tscnlab/Calibration-Adapters-HTC_Vive_Pro_Eye/images/render_radiometric_adapter_front_with_spectroradiometer.jpg

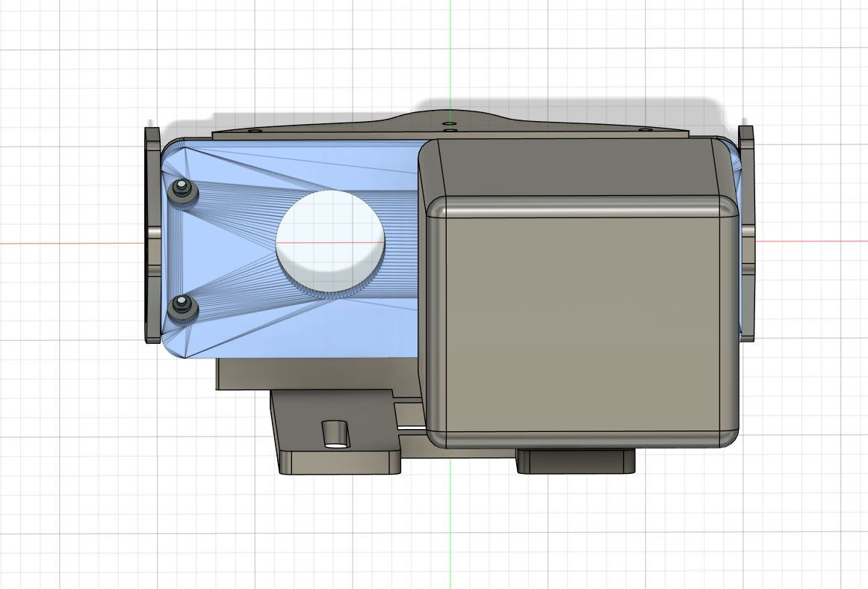
images/render_radiometric_adapter_front_with_spectroradiometer.jpg
