tscnlab/Calibration-Adapters-HTC_Vive_Pro_Eye/README.md

# 3D-printed adapters for standardized radiometric, photometric and temporal display calibration measurements of the HTC Vive Pro Eye virtual reality headset

## Technical note

**Maydel Fernandez-Alonso¹, Carolina Guidolin¹, Alexander Baum², Jannick Romanowski², Markus Scheu², Manuel Spitschan¹˒³**  

¹ Max Planck Research Group Translational Sensory and Circadian Neuroscience, Max Planck Institute for Biological Cybernetics, Tübingen, Germany  
² Fine Mechanical Workshop, Max Planck Institute for Biological Cybernetics, Tübingen, Germany  
³ Chronobiology and Health, TUM School of Medicine and Health, Technical University of Munich, Munich, Germany

### Citation

For citation, see the `CITATION.cff` file.

APA reference:

> Fernandez-Alonso, M., Guidolin, C., Baum, A., Romanowski, J., Scheu, M., & Spitschan, M. (2025). 3D-printed adapters for standardized radiometric, photometric and temporal display calibration measurements of the HTC Vive Pro Eye virtual reality headset [Technical note]. https://doi.org/10.5281/zenodo.15229214

### Included files

The following files are included with this technical note:

- `technical_note.pdf`: Technical note describing the content of this repository

- `models/`: 3D models for the adapters  
  - `radiometric_adapter.step`: 3D model for radiometric adapter  
  - `temporal_response_adapter.step`: 3D model for temporal adapter  

- `images/`: Rendered images of the adapters  
  - `render_radiometric_adapter_bottom.jpg`  
  - `render_radiometric_adapter_front_with_spectroradiometer.jpg`  
  - `render_radiometric_adapter_front.jpg`  
  - `render_radiometric_adapter_side.jpg`  
  - `render_radiometric_adapter_top.jpg`  
  - `render_temporal_adapter_bottom.jpg`  
  - `render_temporal_adapter_front_with_cover_plate.jpg`  
  - `render_temporal_adapter_front_without_cover_plate.jpg`  
  - `render_temporal_adapter_side.jpg`  
  - `render_temporal_adapter_top.jpg`  

- `LICENSE.txt`: Licensing terms

- `CITATION.cff`: Citation information
