tscnlab/Calibration-Adapters-HTC_Vive_Pro_Eye/images/render_radiometric_adapter_bottom.jpg

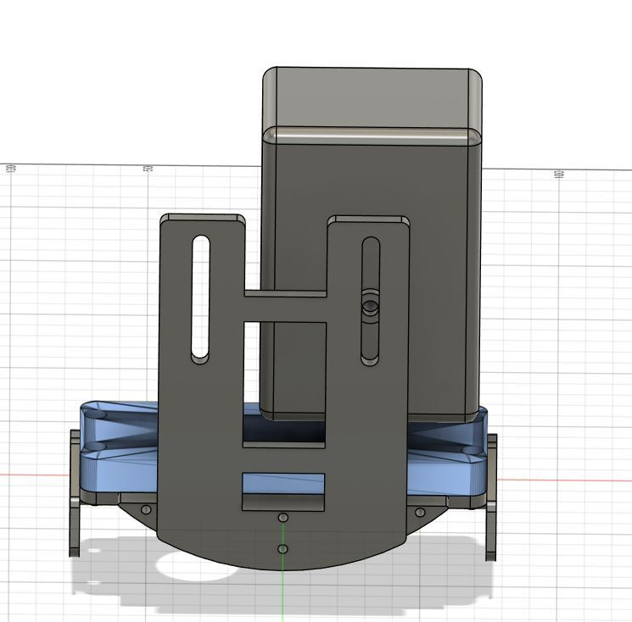
images/render_radiometric_adapter_bottom.jpg
