tscnlab/Calibration-Adapters-HTC_Vive_Pro_Eye/images/render_temporal_adapter_bottom.jpg

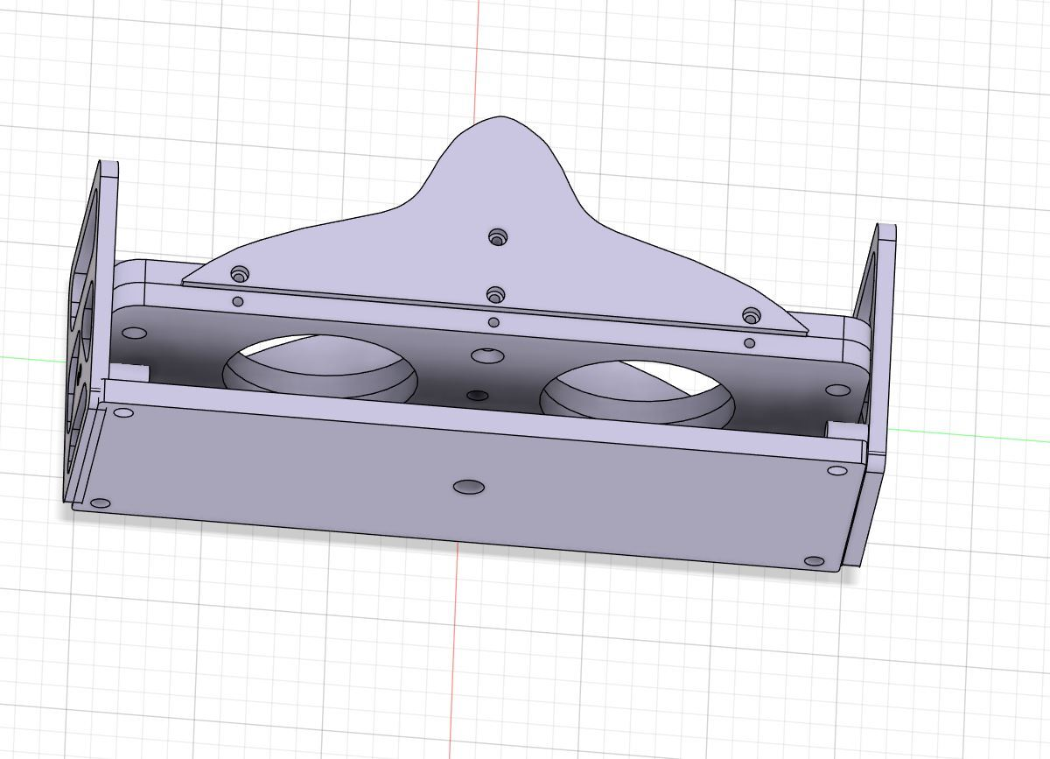
images/render_temporal_adapter_bottom.jpg
