tscnlab/Calibration-Adapters-HTC_Vive_Pro_Eye/images/render_temporal_adapter_front_without_cover_plate.jpg

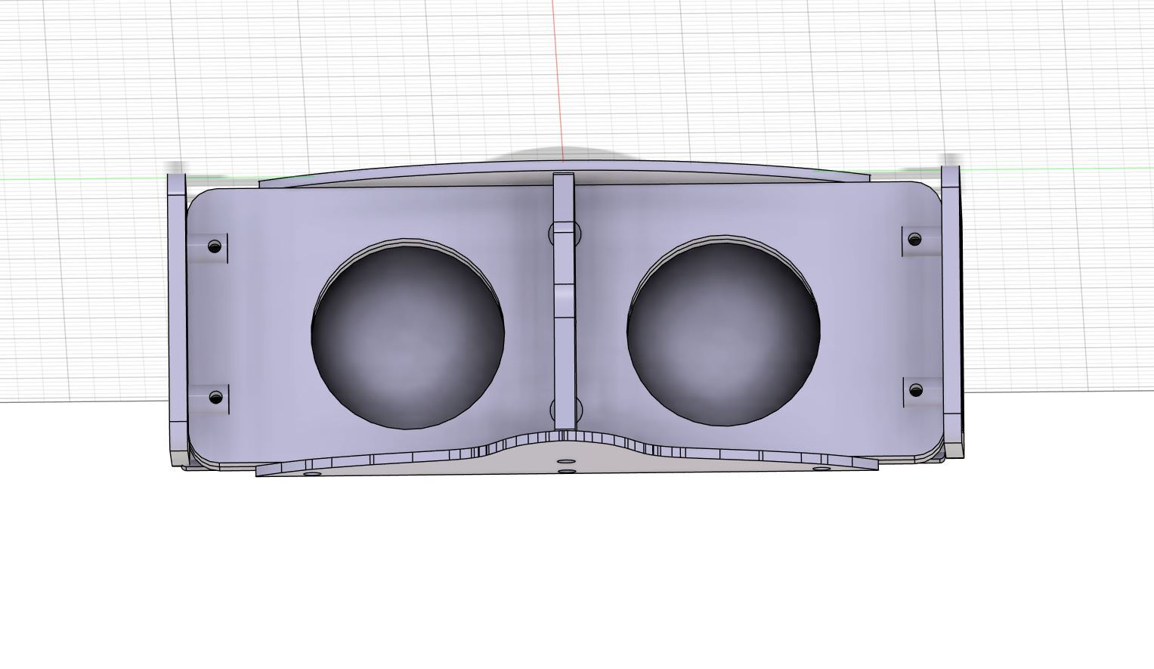
images/render_temporal_adapter_front_without_cover_plate.jpg
