tscnlab/Calibration-Adapters-HTC_Vive_Pro_Eye/images/render_temporal_adapter_side.jpg

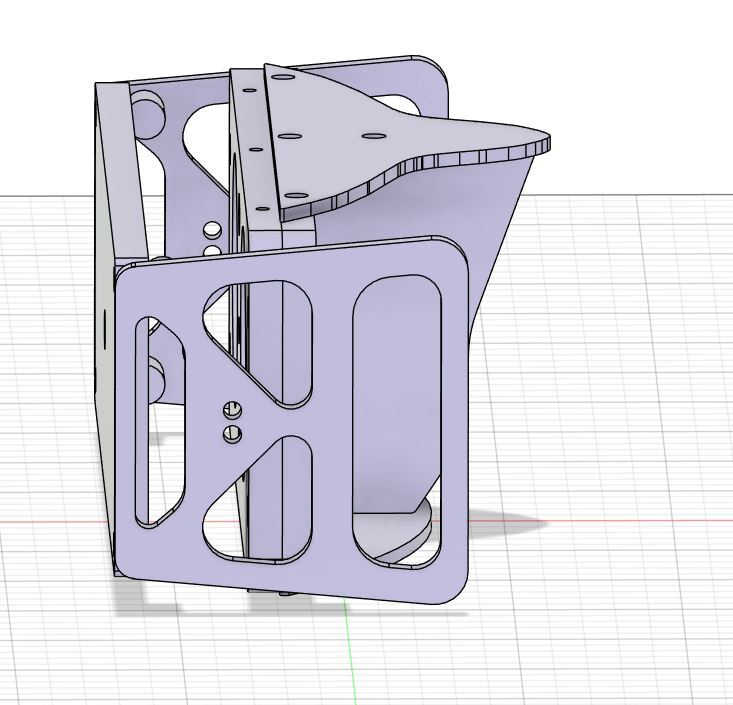
images/render_temporal_adapter_side.jpg
