tscnlab/Calibration-Adapters-HTC_Vive_Pro_Eye/images/render_temporal_adapter_top.jpg

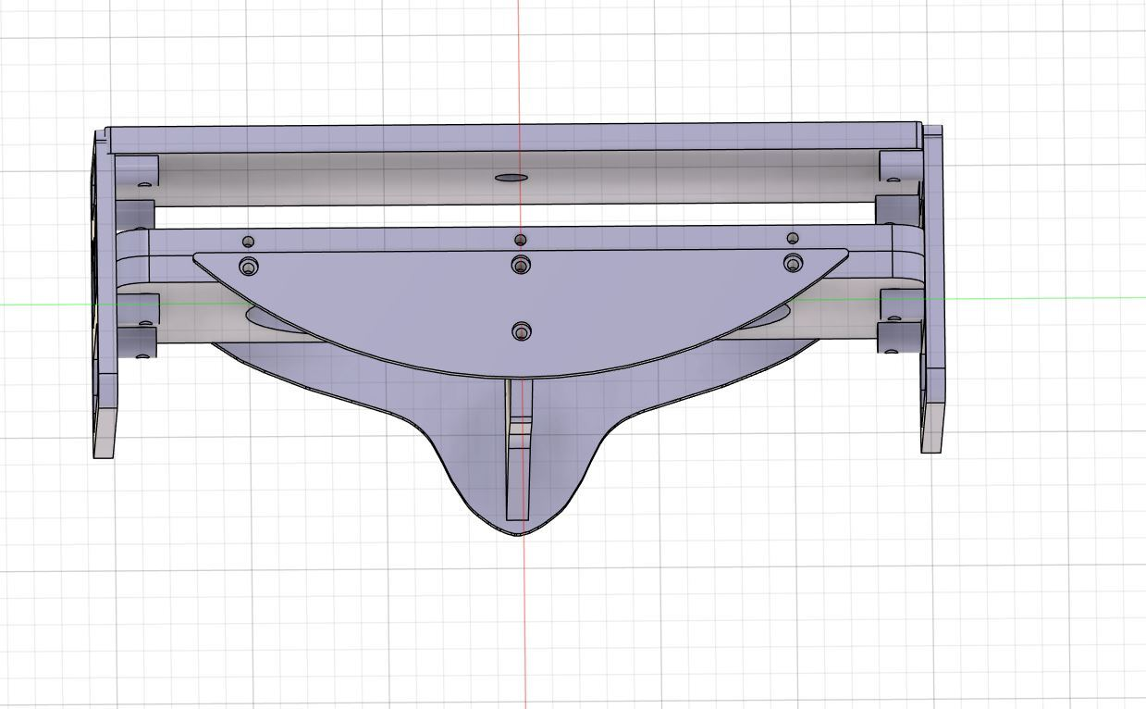
images/render_temporal_adapter_top.jpg
