tscnlab/Calibration-Adapters-HTC_Vive_Pro_Eye/models/temporal_response_adapter.step

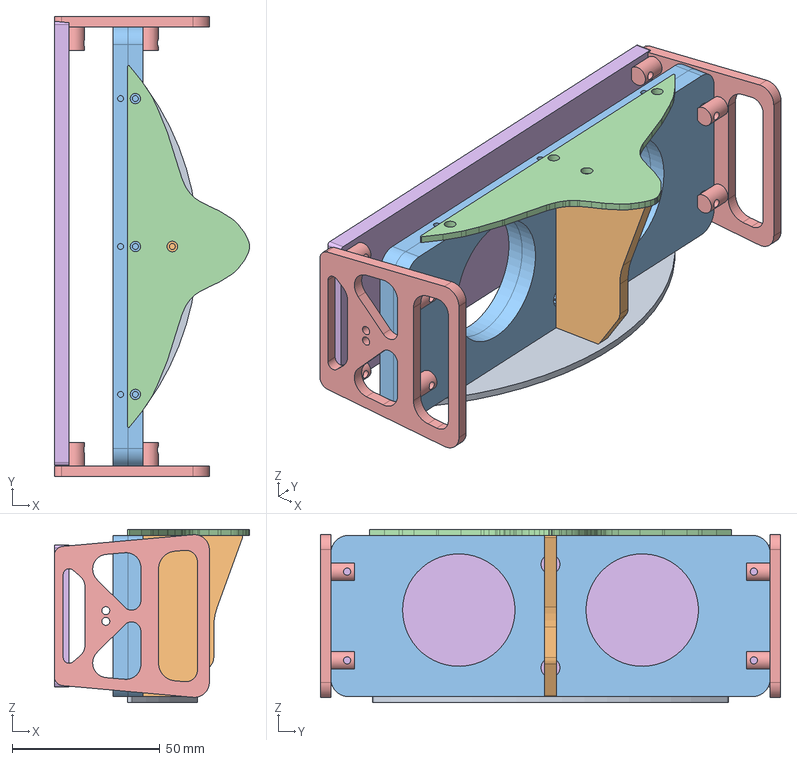
[picture p23: CAD file, 2025-04-16]
models/temporal_response_adapter.step
66.0 x 155.5 x 58.5 mm
Hintere-abdeckung
Sensor-Trennwand
Untere-Sensor-Platte x 2
Obere-Sensor-Platte
