tscnlab/Calibration-Adapters-HTC_Vive_Pro_Eye/(commit log)

2025-04-16 Files added
    [Radiometric adapter.step, Temporal response adapter.step]
2025-04-16 Updated gitignore
    [radiometric_adapter.step, temporal_response_adapter.step]
2025-04-30 updated technical note with details of the 3D printer used
